labitat/SATA-backplane-10-inch-rack/SATA-backplane-10-inch-rack/HDD3-3.5in generic hdd full assembly.step

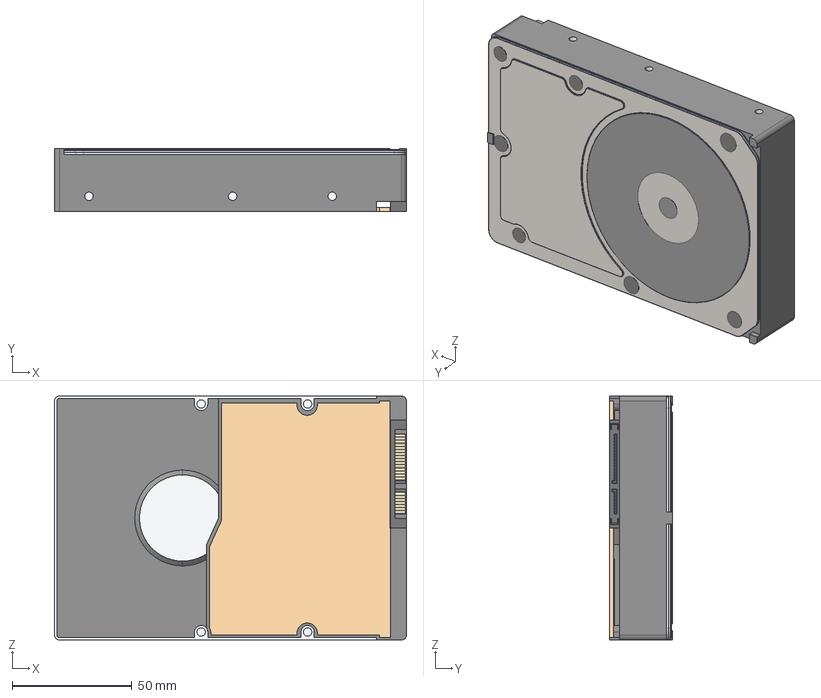
[picture p1: CAD file, 2025-09-09]
SATA-backplane-10-inch-rack/HDD3-3.5in generic hdd full assembly.step
147.0 x 26.1 x 101.8 mm
steel cover
SEAL
Base
Sata connector
pcb
