labitat/SATA-backplane-10-inch-rack/diskcage.stl

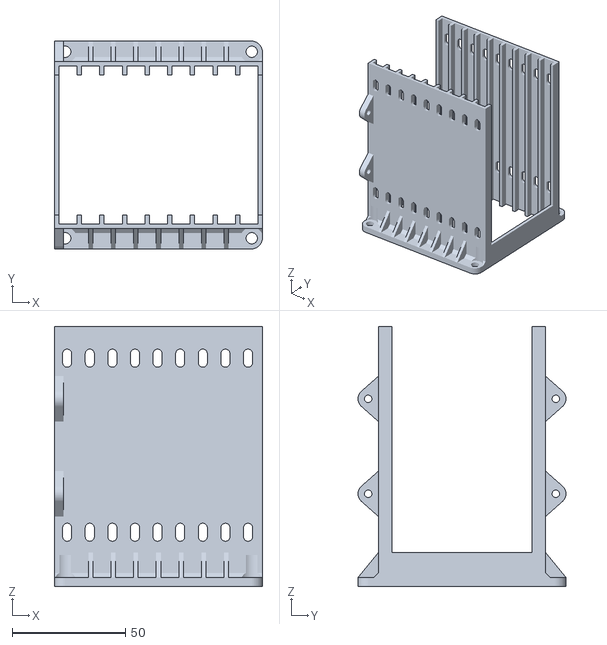
[picture p2: CAD file, 2026-04-03]
diskcage.stl
92.0 x 92.0 x 115.0
