labitat/SATA-backplane-10-inch-rack/FreeCad/3u-NAS_1.5+backplane_UpdatedOutlinePCB.FCStd

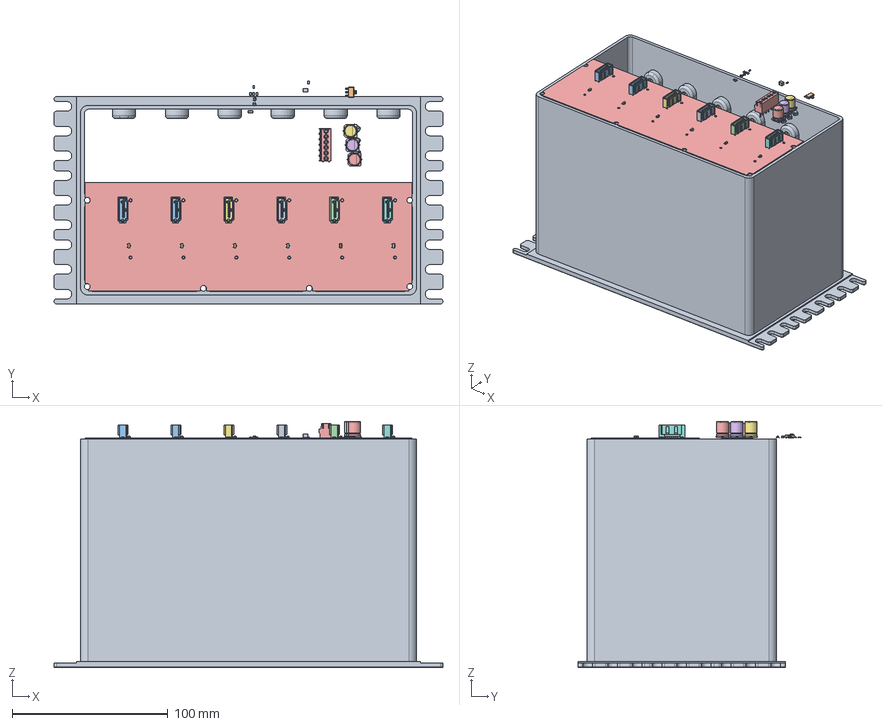
[picture p3: CAD file, 2025-08-31]
FreeCad/3u-NAS_1.5+backplane_UpdatedOutlinePCB.FCStd
250.0 x 143.3 x 158.1 mm
SOT-029
SOT-323_SC-072
CP_Elec_8x10.008
R_0805_2012Metric005
R_0805_2012Metric006
R_0805_2012Metric007
C_1210_3225Metric001
SOT-030
SOT-323_SC-073
SOT-031
TerminalBlock_Phoenix_PT-1,5-6-3.5-H_1x06_P3.50mm_Horizontal001
CP_Elec_8x10.009
CP_Elec_8x10.010
SOT-223
R_0805_2012Metric008
SOT-224
SOT-225
R_0805_2012Metric009
SOT-226
D_SMB003
LED_1206_3216Metric
D_SMB004
D_SMB005
SATA-backplane-10-inch-rack_PCB001
