labitat/SATA-backplane-10-inch-rack/SATA-backplane-10-inch-rack/3u-NAS_Body.step

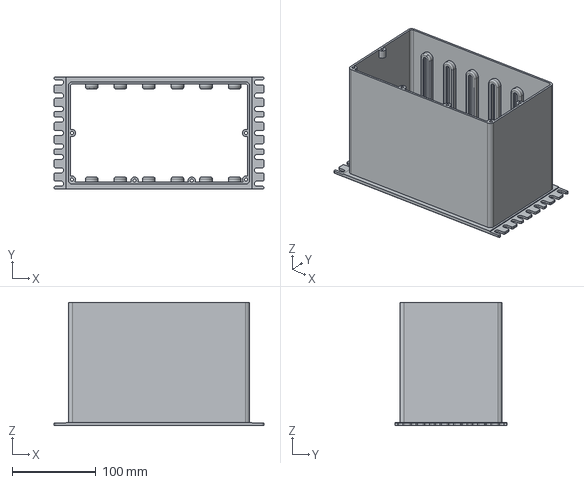
[picture p4: CAD file, 2025-09-09]
SATA-backplane-10-inch-rack/3u-NAS_Body.step
250.0 x 133.3 x 147.0 mm
