labitat/SATA-backplane-10-inch-rack/SATA-backplane-10-inch-rack/SATA-backplane-10-inch-rack.step

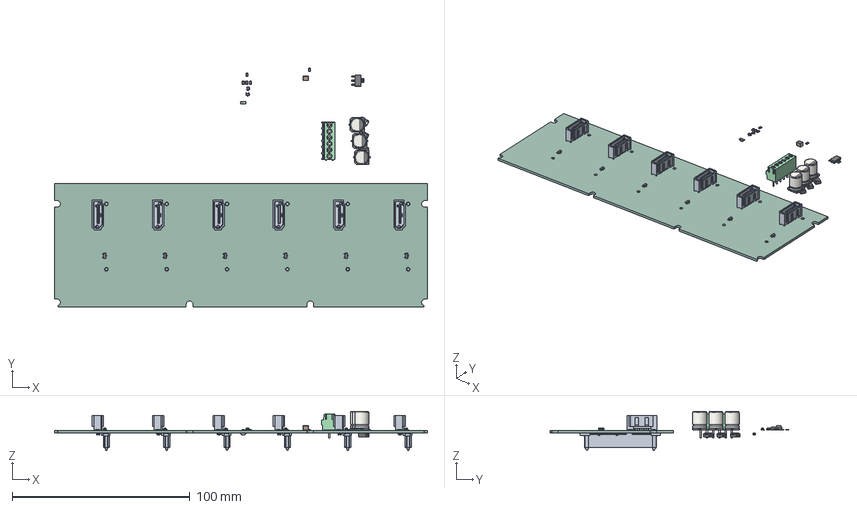
[picture p5: CAD file, 2025-08-31]
SATA-backplane-10-inch-rack/SATA-backplane-10-inch-rack.step
210.1 x 134.8 x 22.0 mm
SOT-23 x 6
SOT-323_SC-70 x 2
CP_Elec_8x10.5 x 3
R_0805_2012Metric x 5
C_1210_3225Metric
TerminalBlock_Phoenix_PT-1,5-6-3.5-H_1x06_P3.50mm_Horizontal
SOT-223
D_SMB x 3
LED_1206_3216Metric
SATA-backplane-10-inch-rack_PCB
