labitat/SATA-backplane-10-inch-rack/(list of files, cad)

Other CAD files:
FreeCad/HDD3.FCStd
