labitat/SATA-backplane-10-inch-rack/SATA-backplane-10-inch-rack/SATA-backplane-10-inch-rack.kicad_pcb

## KiCad design SATA-backplane-10-inch-rack/SATA-backplane-10-inch-rack.kicad_pcb (2025-10-05)

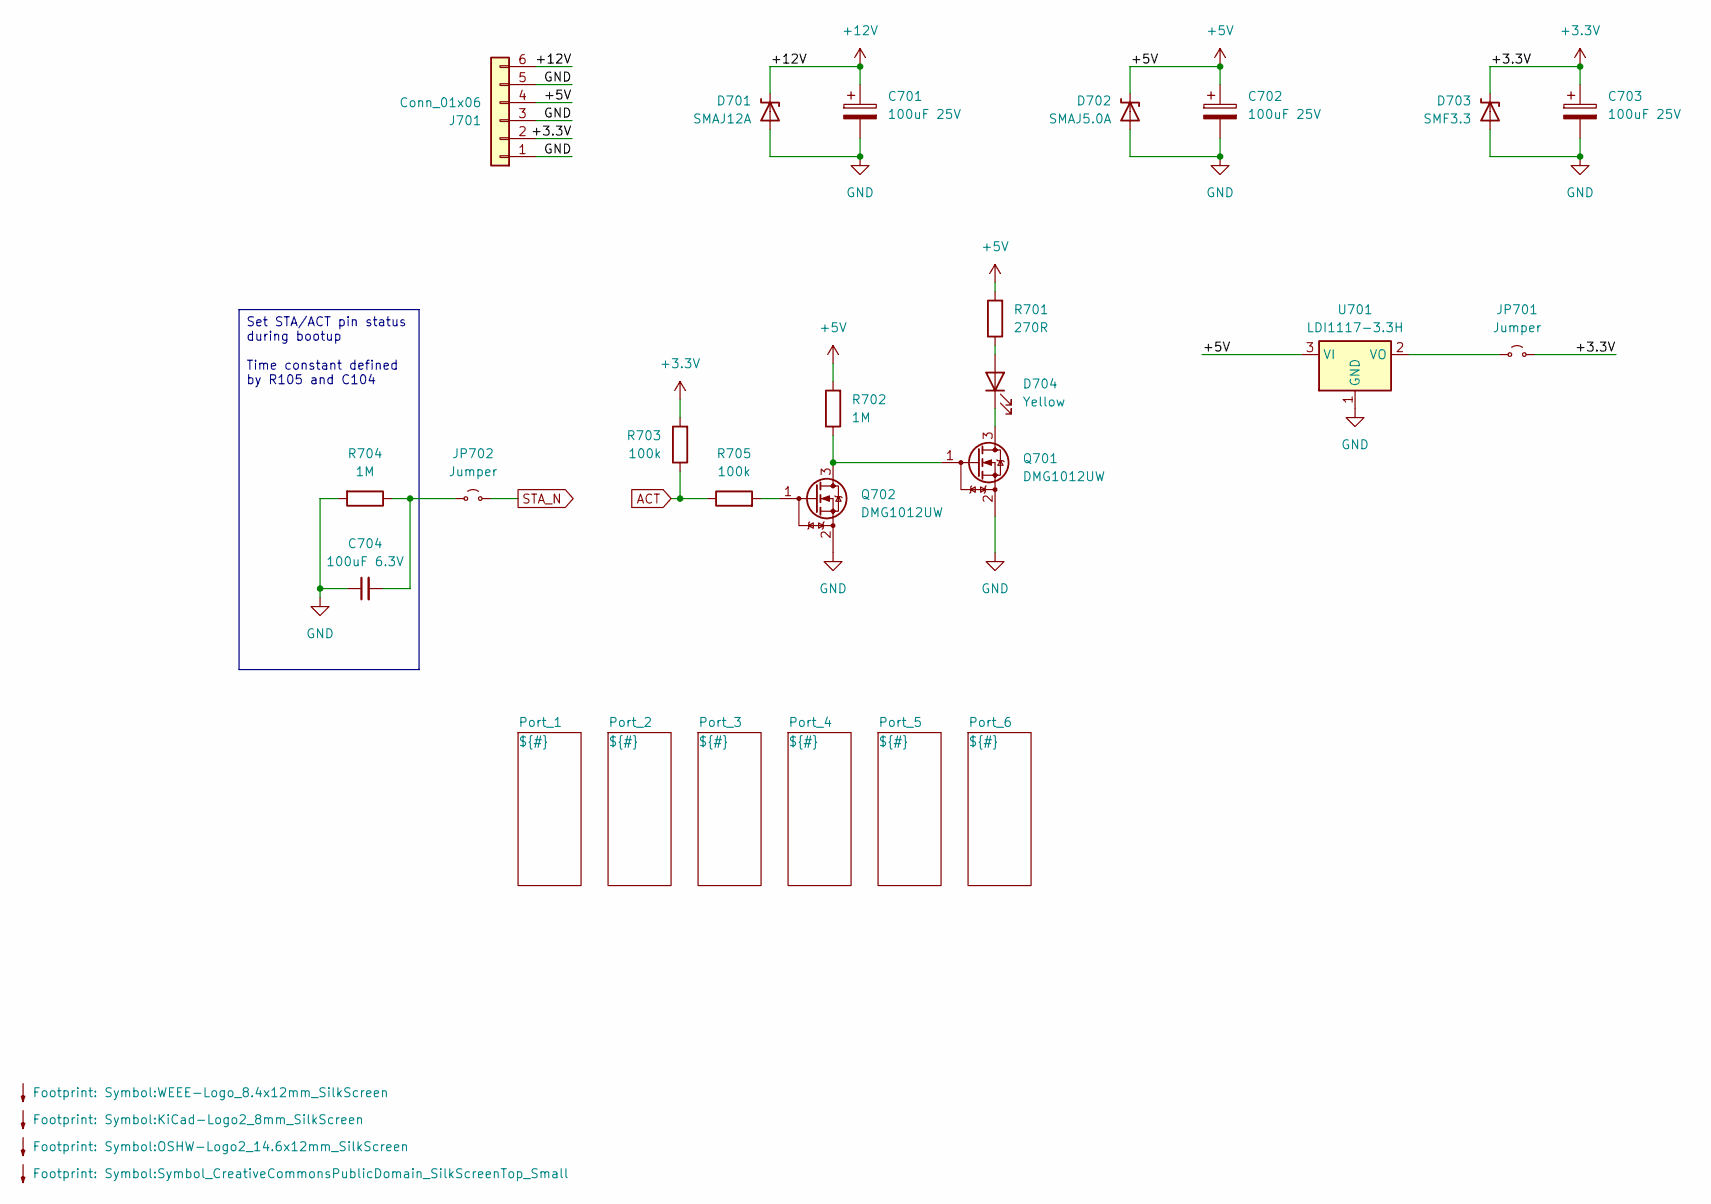
[picture p6: schematic SATA-backplane-10-inch-rack.kicad_sch]

Parts:
C701, C702, C703: 100uF 25V; CP_Elec_8x10.5; Mouser Part Number 667-EEE-HC1E101P
C704: 100uF 6.3V; C_1210_3225Metric_Pad1.33x2.70mm_HandSolder; Manufacturer_Part_Number JMK325BJ107MM-T; Mouser Part Number 963-JMK325BJ107MM-T
D701: SMAJ12A; D_SMA-SMB_Universal_Handsoldering; Mouser Part Number 652-SMAJ12A
D702: SMAJ5.0A; D_SMA-SMB_Universal_Handsoldering; Mouser Part Number 652-SMAJ5.0A
D703: SMF3.3; D_SMA-SMB_Universal_Handsoldering; Mouser Part Number 576-SMF3.3
D704: Yellow; LED_D3.0mm_Clear; Manufacturer_Part_Number LTL-4251N; Mouser Part Number 859-LTL-4251N
J701: Conn_01x06; TerminalBlock_Phoenix_PT-1,5-6-3.5-H_1x06_P3.50mm_Horizontal; Mouser Part Number 651-1984659
JP701, JP702: Jumper; PinHeader_1x02_P2.54mm_Horizontal; Manufacturer_Part_Number 22-28-8024; Mouser Part Number 538-22-28-8024
Q701, Q702: DMG1012UW; SOT-323_SC-70_Handsoldering; Manufacturer_Part_Number DMG1012UW-7; Mouser Part Number 621-DMG1012UW-7
R701: 270R; R_0805_2012Metric_Pad1.20x1.40mm_HandSolder; Manufacturer_Part_Number AC0805FR-07270RL; Mouser Part Number 603-AC0805FR-07270RL
R702, R704: 1M; R_0805_2012Metric_Pad1.20x1.40mm_HandSolder; Manufacturer_Part_Number AC0805FR-071ML; Mouser Part Number 603-AC0805FR-071ML
R703, R705: 100k; R_0805_2012Metric_Pad1.20x1.40mm_HandSolder; Manufacturer_Part_Number AC0805FR-07100KL; Mouser Part Number 603-AC0805FR-07100KL
SYM701: Symbol_CreativeCommonsPublicDomain_SilkScreenTop_Small
SYM702: WEEE-Logo_8.4x12mm_SilkScreen
SYM704: OSHW-Logo2_14.6x12mm_SilkScreen
SYM705: KiCad-Logo2_8mm_SilkScreen
U701: LDI1117-3.3H; SOT-223-3_TabPin2; Manufacturer_Part_Number LDI1117-3.3H; Mouser Part Number 637-LDI1117-3.3H

Connections:
+3.3V: C703.1, D703.1 (A1), J701.2, JP701.1 (A), R703.2; also elsewhere on the board
+5V: C702.1, D702.1 (A1), J701.4, R701.2, R702.2, U701.3 (VI); also elsewhere on the board
+12V: C701.1, D701.1 (A1), J701.6; also elsewhere on the board
ACT: R703.1, R705.1; also elsewhere on the board
GND: C701.2, C702.2, C703.2, C704.1, D701.2 (A2), D702.2 (A2), D703.2 (A2), J701.1, J701.3, J701.5, Q701.2 (S), Q702.2 (S), R704.2, U701.1 (GND); also elsewhere on the board
unnamed: D704.2 (A), R701.1
unnamed: D704.1 (K), Q701.3 (D)
unnamed: JP701.2 (B), U701.2 (VO)
unnamed: C704.2, JP702.2 (B), R704.1
unnamed: Q701.1 (G), Q702.3 (D), R702.1
unnamed: Q702.1 (G), R705.2
STA_N: JP702.1 (A); also elsewhere on the board

Notes on the sheet:
Set STA/ACT pin status during bootup Time constant defined by R105 and C104

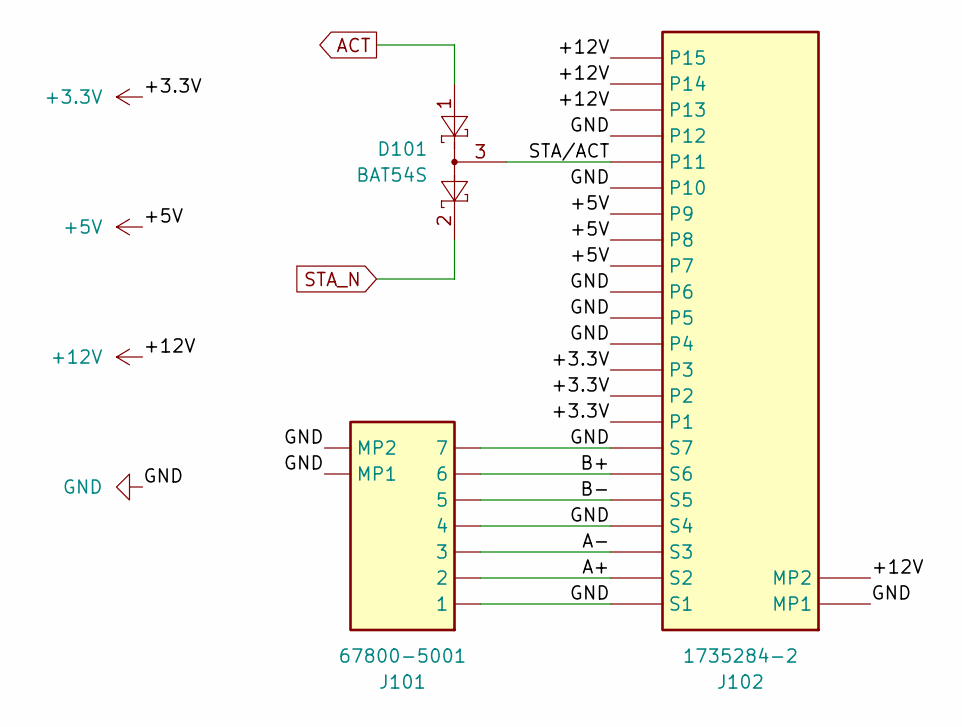
[picture p7: schematic Port.kicad_sch]

Parts:
D101: BAT54S; SOT-23_Handsoldering; Mouser Part Number 637-BAT54S
J101: 67800-5001; 67800-5005_2; Manufacturer_Part_Number 67800-5001; Mouser Part Number 538-67800-5001
J102: 1735284-2; 17352842; Manufacturer_Part_Number 1735284-2; Mouser Part Number 571-1735284-2

Connections:
+3.3V: J102.P1, J102.P2, J102.P3; also elsewhere on the board
+5V: J102.P7, J102.P8, J102.P9; also elsewhere on the board
+12V: J102.MP2, J102.P13, J102.P14, J102.P15; also elsewhere on the board
/Port_1/A+: J101.2, J102.S2
/Port_1/A-: J101.3, J102.S3
/Port_1/B+: J101.6, J102.S6
/Port_1/B-: J101.5, J102.S5
/Port_1/STA/ACT: D101.3 (COM), J102.P11
ACT: D101.1 (A); also elsewhere on the board
GND: J101.1, J101.4, J101.7, J101.8 (MP1), J101.9 (MP2), J102.MP1, J102.P4, J102.P5, J102.P6, J102.P10, J102.P12, J102.S1, J102.S4, J102.S7; also elsewhere on the board
STA_N: D101.2 (K); also elsewhere on the board

Parts of its further copies:
D201, D301, D401, D501, D601: BAT54S; SOT-23_Handsoldering; Mouser Part Number 637-BAT54S
J201, J301, J401, J501, J601: 67800-5001; 67800-5005_2; Manufacturer_Part_Number 67800-5001; Mouser Part Number 538-67800-5001
J202, J302, J402, J502, J602: 1735284-2; 17352842; Manufacturer_Part_Number 1735284-2; Mouser Part Number 571-1735284-2

Connections of its further copies:
+3.3V: J202.P1, J202.P2, J202.P3, J302.P1, J302.P2, J302.P3, J402.P1, J402.P2, J402.P3, J502.P1, J502.P2, J502.P3, J602.P1, J602.P2, J602.P3; also elsewhere on the board
+5V: J202.P7, J202.P8, J202.P9, J302.P7, J302.P8, J302.P9, J402.P7, J402.P8, J402.P9, J502.P7, J502.P8, J502.P9, J602.P7, J602.P8, J602.P9; also elsewhere on the board
+12V: J202.MP2, J202.P13, J202.P14, J202.P15, J302.MP2, J302.P13, J302.P14, J302.P15, J402.MP2, J402.P13, J402.P14, J402.P15, J502.MP2, J502.P13, J502.P14, J502.P15, J602.MP2, J602.P13, J602.P14, J602.P15; also elsewhere on the board
/Port_2/A+: J201.2, J202.S2
/Port_2/A-: J201.3, J202.S3
/Port_2/B+: J201.6, J202.S6
/Port_2/B-: J201.5, J202.S5
/Port_2/STA/ACT: D201.3 (COM), J202.P11
/Port_3/A+: J301.2, J302.S2
/Port_3/A-: J301.3, J302.S3
/Port_3/B+: J301.6, J302.S6
/Port_3/B-: J301.5, J302.S5
/Port_3/STA/ACT: D301.3 (COM), J302.P11
/Port_4/A+: J401.2, J402.S2
/Port_4/A-: J401.3, J402.S3
/Port_4/B+: J401.6, J402.S6
/Port_4/B-: J401.5, J402.S5
/Port_4/STA/ACT: D401.3 (COM), J402.P11
/Port_5/A+: J501.2, J502.S2
/Port_5/A-: J501.3, J502.S3
/Port_5/B+: J501.6, J502.S6
/Port_5/B-: J501.5, J502.S5
/Port_5/STA/ACT: D501.3 (COM), J502.P11
/Port_6/A+: J601.2, J602.S2
/Port_6/A-: J601.3, J602.S3
/Port_6/B+: J601.6, J602.S6
/Port_6/B-: J601.5, J602.S5
/Port_6/STA/ACT: D601.3 (COM), J602.P11
ACT: D201.1 (A), D301.1 (A), D401.1 (A), D501.1 (A), D601.1 (A); also elsewhere on the board
GND: J201.1, J201.4, J201.7, J201.8 (MP1), J201.9 (MP2), J202.MP1, J202.P4, J202.P5, J202.P6, J202.P10, J202.P12, J202.S1, J202.S4, J202.S7, J301.1, J301.4, J301.7, J301.8 (MP1), J301.9 (MP2), J302.MP1, J302.P4, J302.P5, J302.P6, J302.P10, J302.P12, J302.S1, J302.S4, J302.S7, J401.1, J401.4, J401.7, J401.8 (MP1), J401.9 (MP2), J402.MP1, J402.P4, J402.P5, J402.P6, J402.P10, J402.P12, J402.S1, J402.S4, J402.S7, J501.1, J501.4, J501.7, J501.8 (MP1), J501.9 (MP2), J502.MP1, J502.P4, J502.P5, J502.P6, J502.P10, J502.P12, J502.S1, J502.S4, J502.S7, J601.1, J601.4, J601.7, J601.8 (MP1), J601.9 (MP2), J602.MP1, J602.P4, J602.P5, J602.P6, J602.P10, J602.P12, J602.S1, J602.S4, J602.S7; also elsewhere on the board
STA_N: D201.2 (K), D301.2 (K), D401.2 (K), D501.2 (K), D601.2 (K); also elsewhere on the board

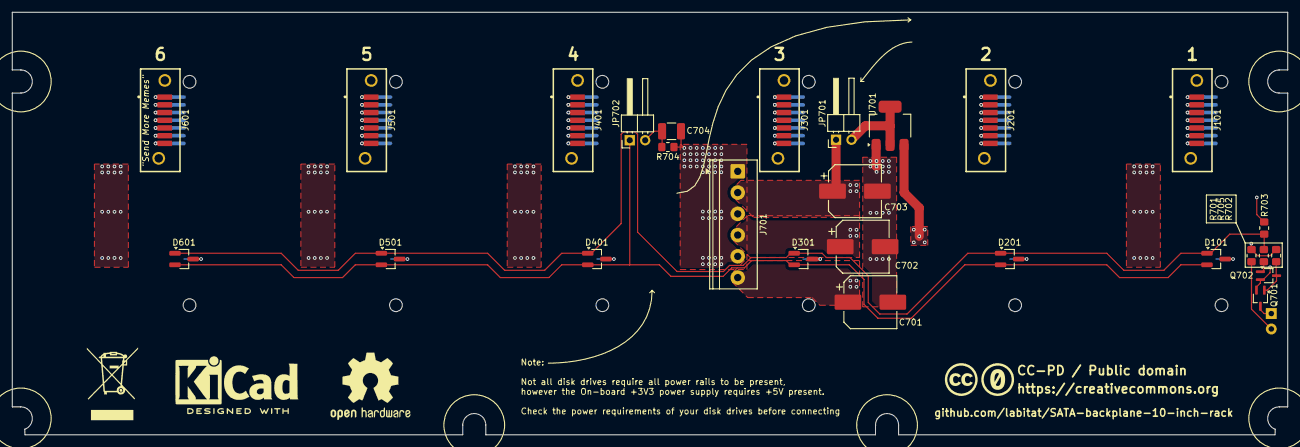
[picture p8: board SATA-backplane-10-inch-rack.kicad_pcb from above]

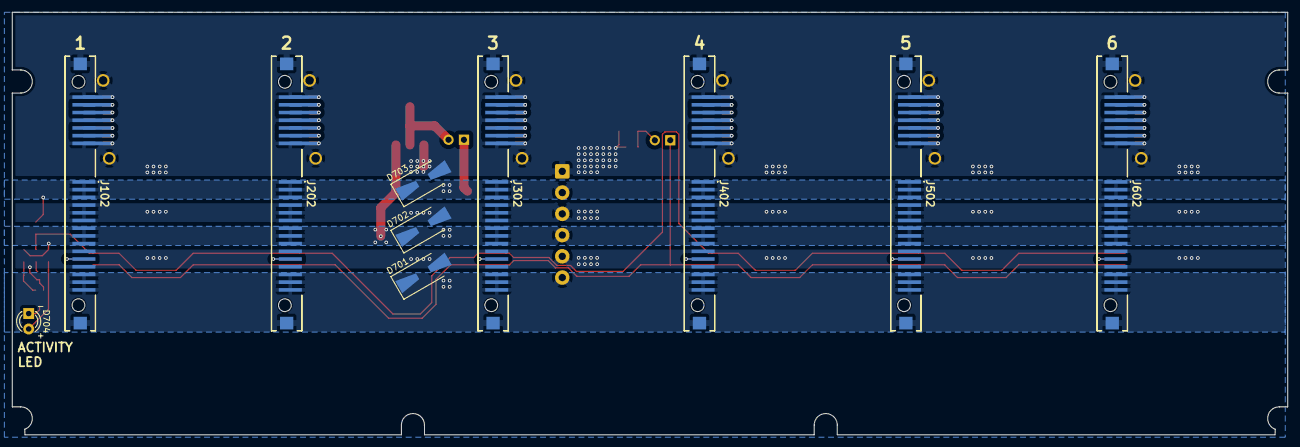
[picture p9: board SATA-backplane-10-inch-rack.kicad_pcb from below]

Board: 2 copper layers, 210.1 x 69.6 mm, 42 parts (10 on the bottom side), 42 nets.

Other parts of the board:
Ref**: BOM_additional_purcase_order
