labitat/SATA-backplane-10-inch-rack/Fan Controler Setup Guide.png

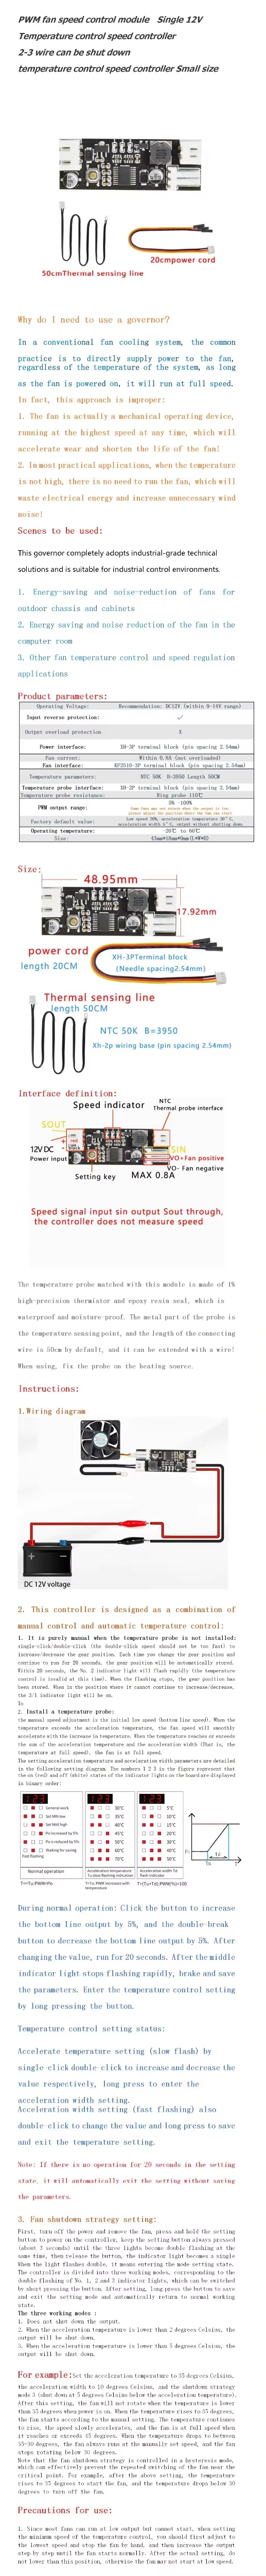
Fan Controler Setup Guide.png
