labitat/SATA-backplane-10-inch-rack/(commit log)

2025-02-10 Init shematic
    [SATA-backplane-10-inch-rack.kicad_pcb, SATA-backplane-10-inch-rack.kicad_sch]
2025-02-11 Draw 12-module layout example
    [Port.kicad_sch, SATA-backplane-10-inch-rack.kicad_pcb, SATA-backplane-10-inch-rack.kicad_sch, power.kicad_sch]
2025-02-13 More realistic layout
    [Port.kicad_sch, SATA-backplane-10-inch-rack.kicad_pcb, SATA-backplane-10-inch-rack.kicad_sch, power.kicad_sch]
2025-02-14 STA/ACT implemented in layout
    [Port.kicad_sch, SATA-backplane-10-inch-rack.kicad_pcb, SATA-backplane-10-inch-rack.kicad_sch]
2025-02-21 add capacitor discharge
    [Port.kicad_sch, SATA-backplane-10-inch-rack.kicad_pcb, SATA-backplane-10-inch-rack.kicad_sch]
2025-03-26 Add 6 x 3½" HDD outline and measures
    [Port.kicad_sch, SATA-backplane-10-inch-rack.kicad_pcb, SATA-backplane-10-inch-rack.kicad_sch]
2025-03-31 Adapt to 6 x 3½" version using the multichannel tool
    [Port.kicad_sch, SATA-backplane-10-inch-rack.kicad_pcb, SATA-backplane-10-inch-rack.kicad_sch]
2025-05-06 Fix Sta/Act signal definition
    [SATA-backplane-10-inch-rack.kicad_sch]
2025-05-06 Align outline and mounting holes with Jeppe
    [SATA-backplane-10-inch-rack.kicad_pcb, SATA-backplane-10-inch-rack.kicad_sch, SATA-backplane-10-inch-rack.step]
2025-05-06 Prepare layout
    [SATA-backplane-10-inch-rack.kicad_pcb]
2025-05-06 Fiddling with layout
    [Port.kicad_sch, SATA-backplane-10-inch-rack.kicad_pcb, SATA-backplane-10-inch-rack.kicad_sch]
2025-08-31 Add FreeCad files and merge with PCB STEP export
    [3u-NAS_1.5+backplane_UpdatedOutlinePCB.FCStd, HDD3.FCStd, SATA-backplane-10-inch-rack.step]
2025-09-09 Place & Route
    [Port.kicad_sch, SATA-backplane-10-inch-rack.kicad_pcb, SATA-backplane-10-inch-rack.kicad_sch]
2025-09-09 Finish layout
    Plus backport 3D into KiCAD
    [3u-NAS_Body.step, HDD3-3.5in generic hdd full assembly.step, SATA-backplane-10-inch-rack.kicad_pcb, SATA-backplane-10-inch-rack.kicad_sch]
2025-10-02 Add text ACT to D104
    [SATA-backplane-10-inch-rack.kicad_sch]
2025-10-02 Update PCB from schematic
    [SATA-backplane-10-inch-rack.kicad_pcb]
2025-10-02 Add final silkscreen items
    [SATA-backplane-10-inch-rack.kicad_pcb]
2025-10-02 Schematic : define temporary mfg.partnumbers
    [Port.kicad_sch, SATA-backplane-10-inch-rack.kicad_pcb, SATA-backplane-10-inch-rack.kicad_sch]
2025-10-05 Rearrange reference designators numbering and silkscreen items
    [Port.kicad_sch, SATA-backplane-10-inch-rack.kicad_pcb, SATA-backplane-10-inch-rack.kicad_sch]
2026-03-02 Add OpenSCAD parametric SSD cage bracket
    [diskcage.scad, diskcage.stl]
2026-04-03 Adding disk cage for HP t740 setup
    [diskcage.scad, diskcage.stl]
2026-04-07 update cages with mounting plates
    [diskcage.scad]
2026-04-07 Adjust to final dimensions
    [diskcage.scad]
2026-05-06 Add fan controller setup guide image
