labitat/SATA-backplane-10-inch-rack/(notices)

Notices in the files:
parts and their libraries:
CC-PD / Public domain
